FredJ21/Boite_a_M/img/img1.png

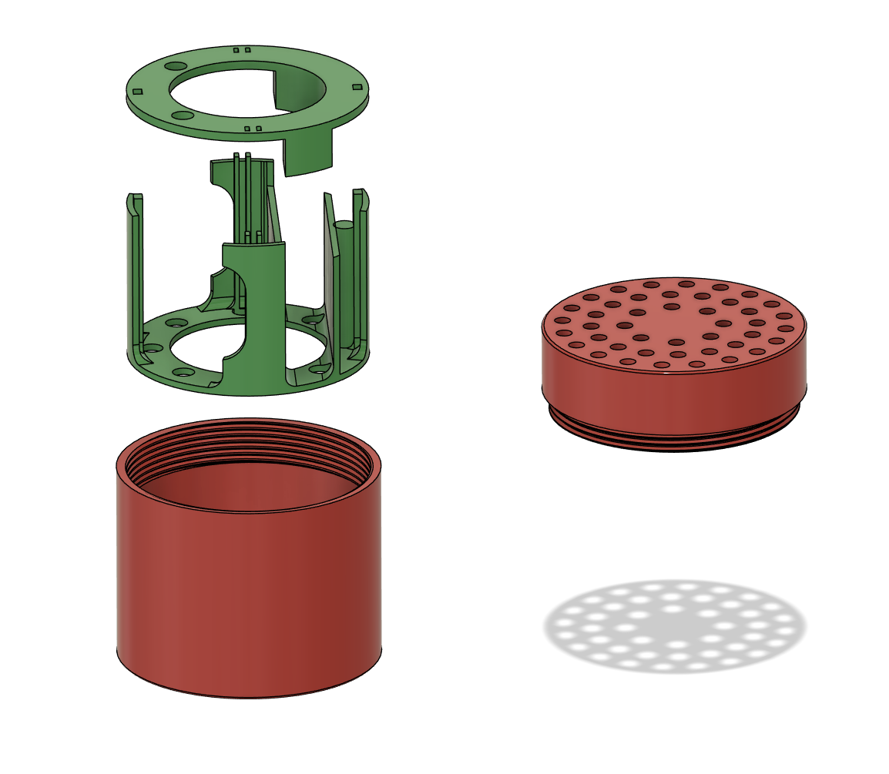
img/img1.png
