FredJ21/Boite_a_M/img/img10.png

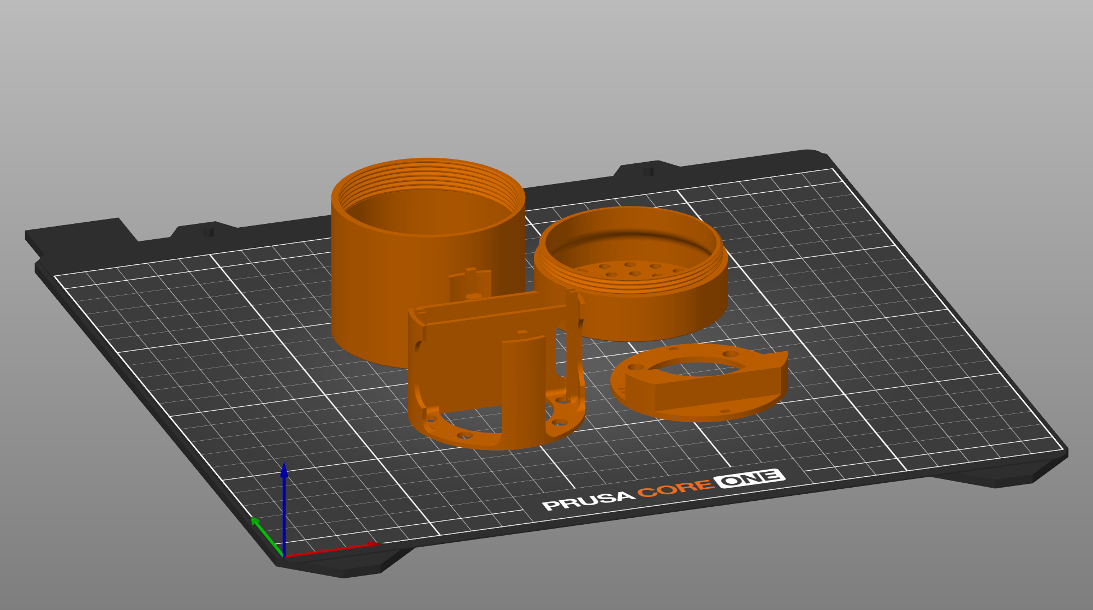
img/img10.png
