FredJ21/Boite_a_M/img/img_4726.png

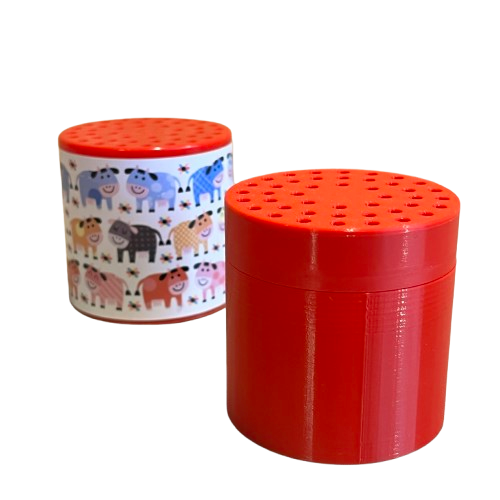
img/img_4726.png
