FredJ21/Boite_a_M/photos/IMG_4679.JPEG

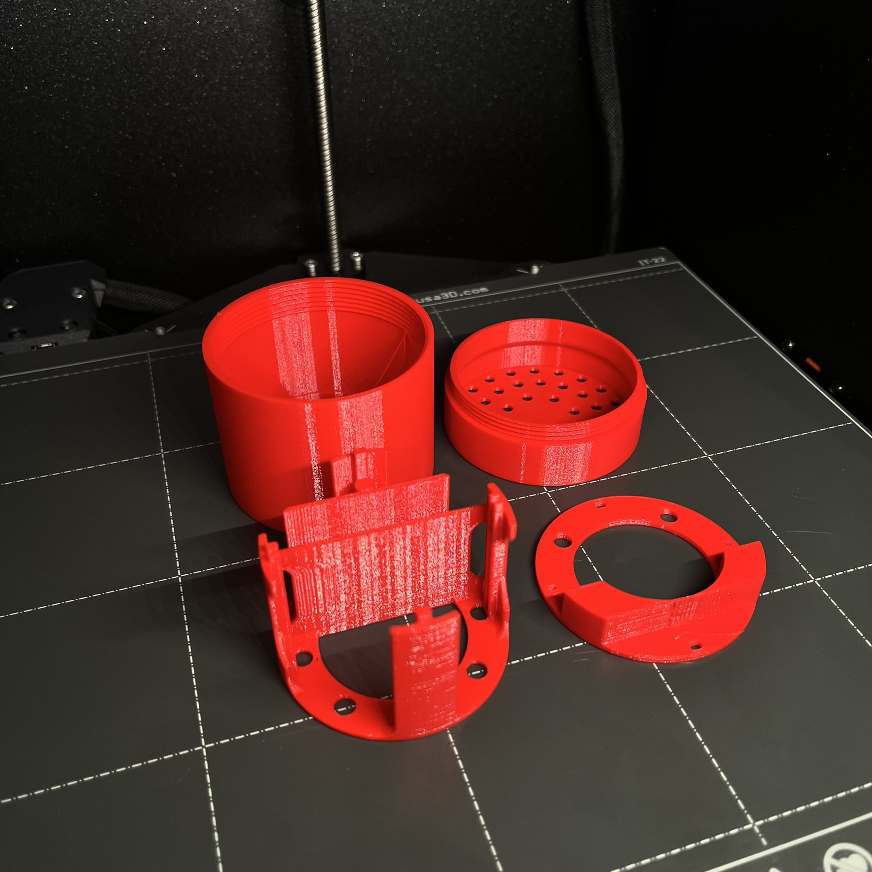
photos/IMG_4679.JPEG
