FredJ21/Boite_a_M/photos/IMG_4681.JPEG

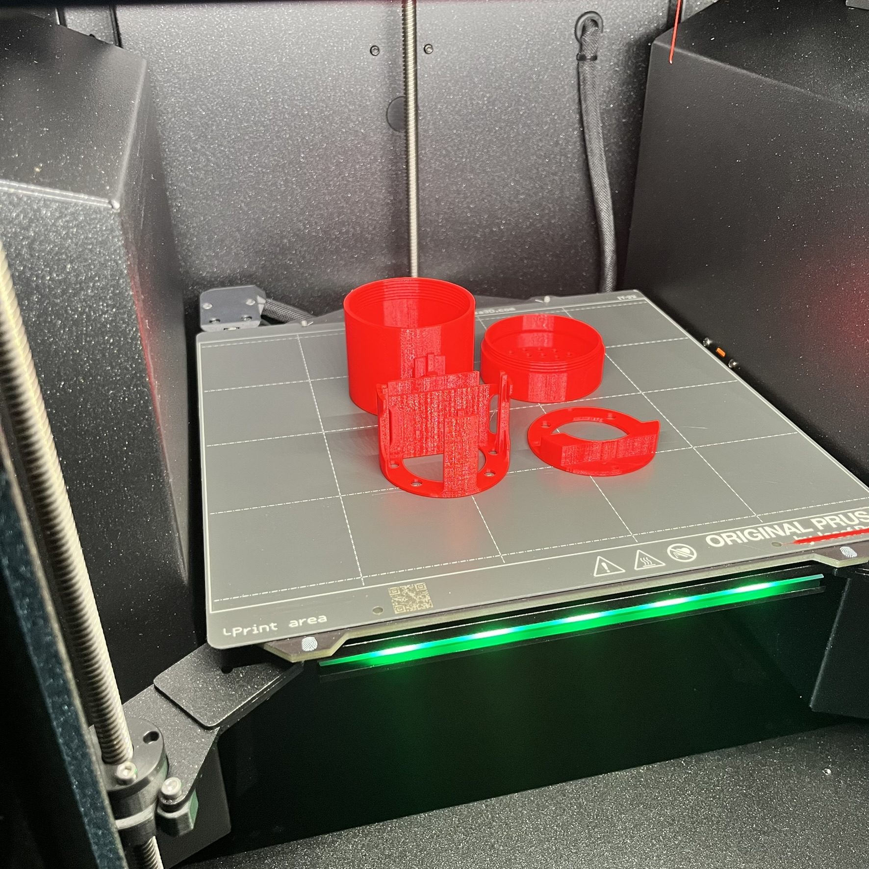
photos/IMG_4681.JPEG
