FredJ21/Boite_a_M/photos/IMG_4686.JPEG

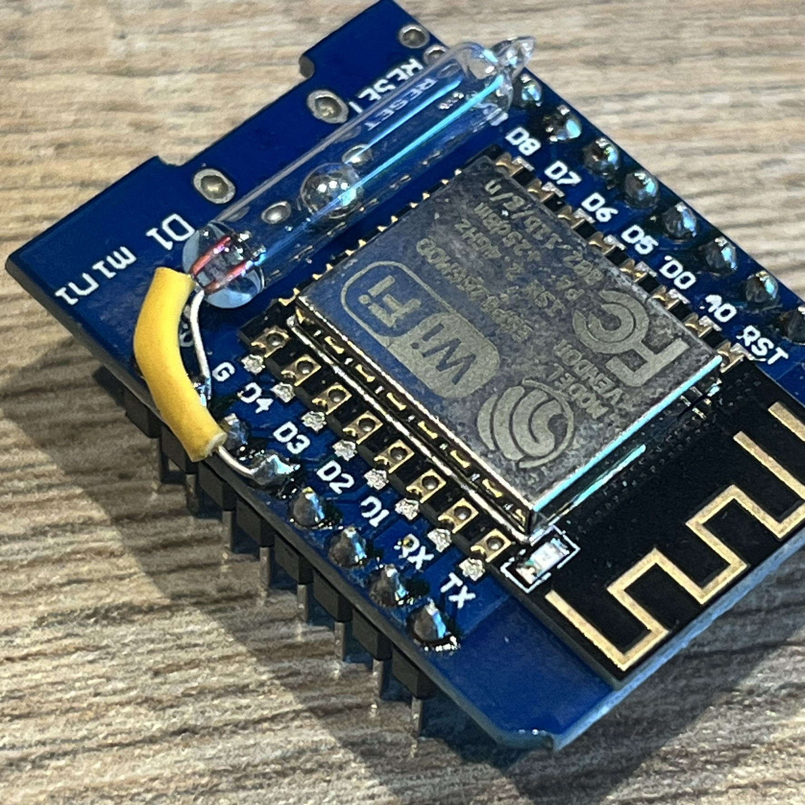
photos/IMG_4686.JPEG
