FredJ21/Boite_a_M/photos/IMG_4687.JPEG

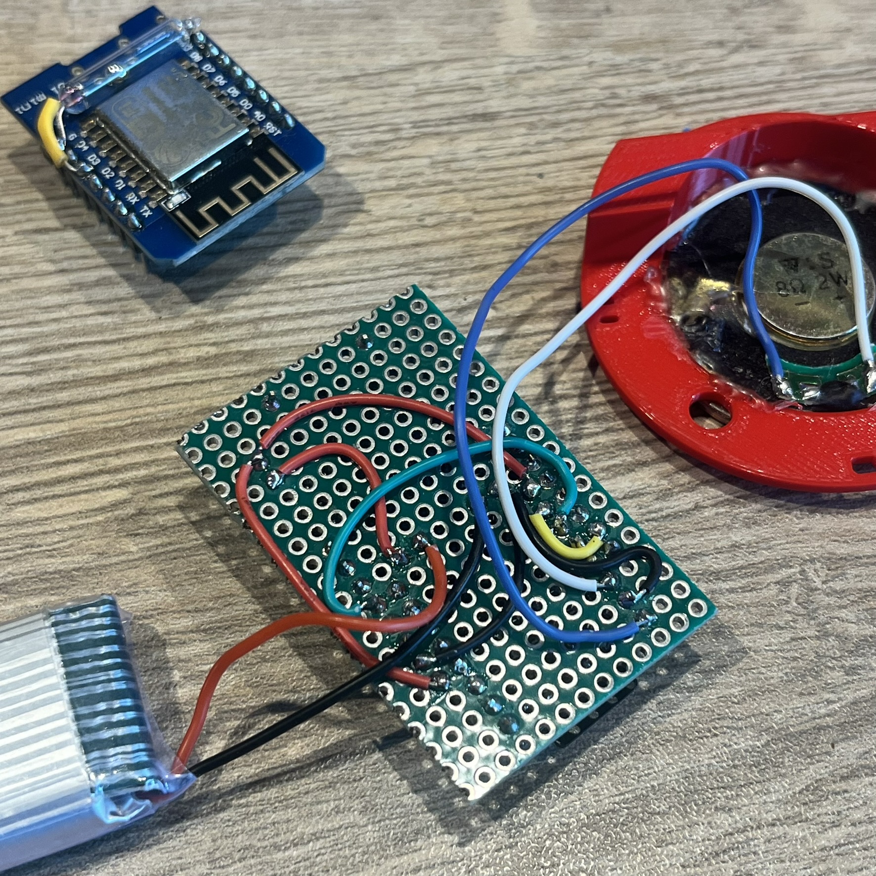
photos/IMG_4687.JPEG
