FredJ21/Boite_a_M/photos/IMG_4689.JPEG

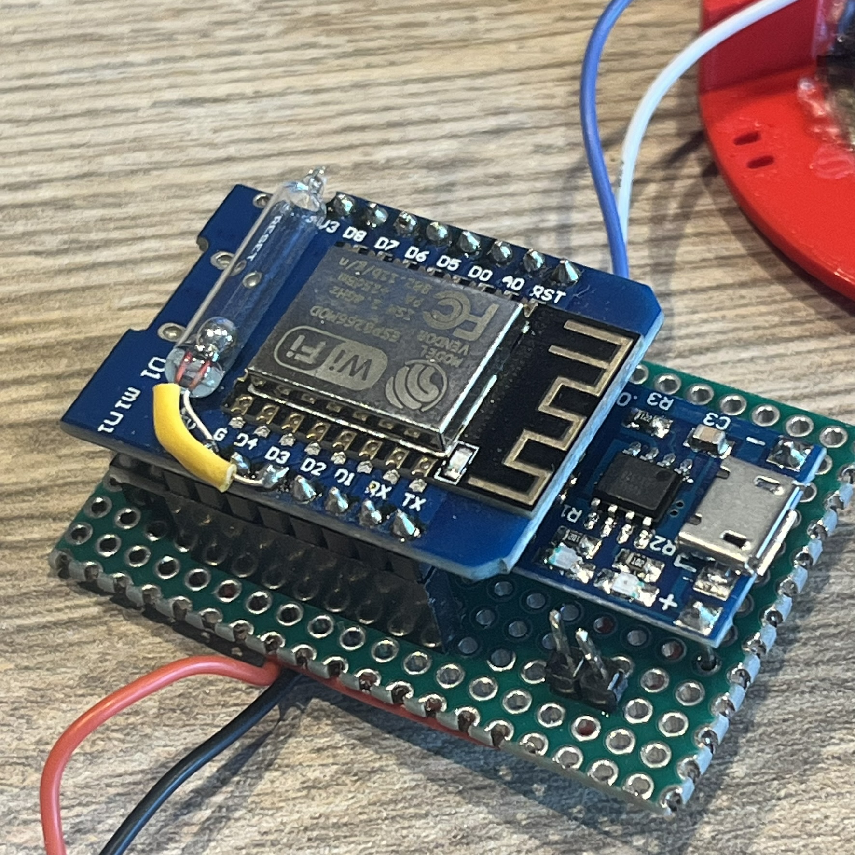
photos/IMG_4689.JPEG
