FredJ21/Boite_a_M/photos/IMG_4724.JPEG

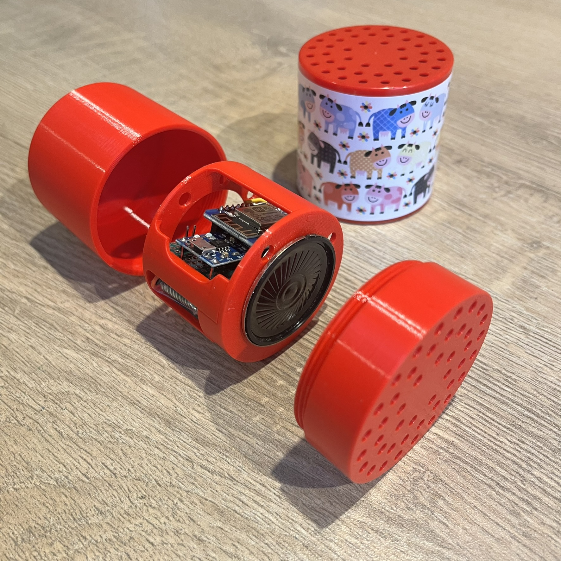
photos/IMG_4724.JPEG
