FredJ21/Boite_a_M/photos/IMG_4725.JPEG

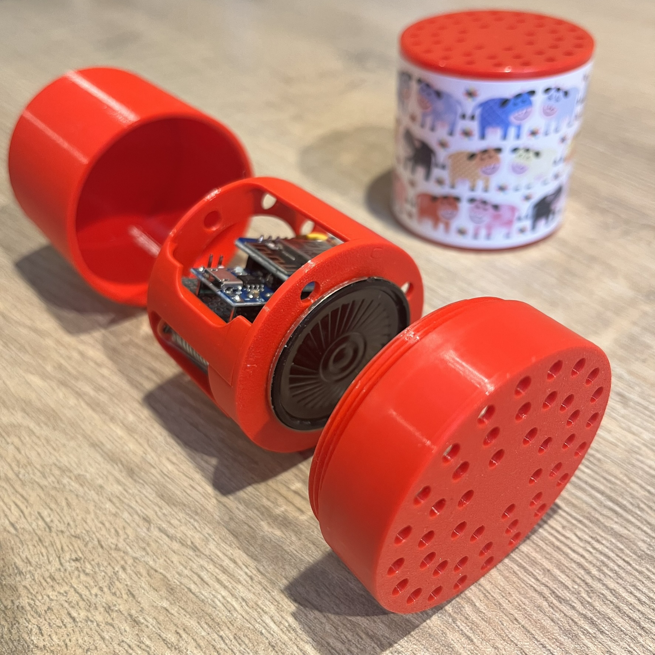
photos/IMG_4725.JPEG
