FredJ21/Boite_a_M/photos/IMG_4727.JPEG

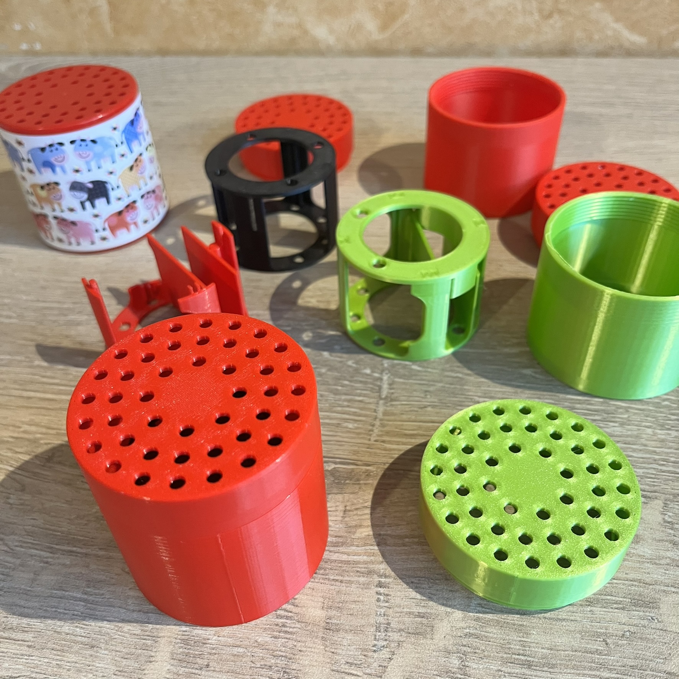
photos/IMG_4727.JPEG
