FredJ21/Boite_a_M/STL/support_ci_2.stl

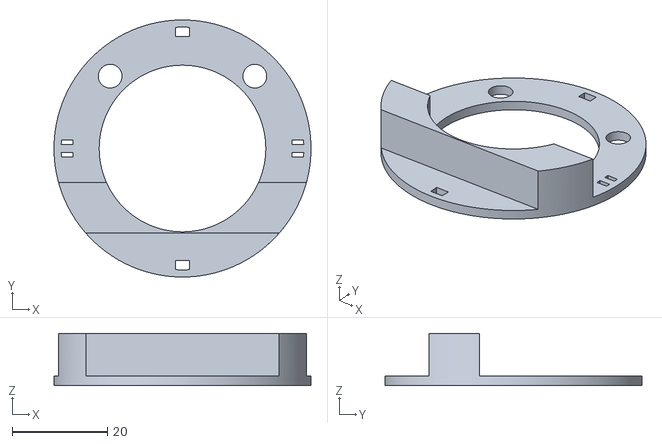
[picture p30: CAD file, 2025-07-22]
STL/support_ci_2.stl
54.0 x 54.0 x 11.0
