FredJ21/Boite_a_M/STL/support_ci_1.stl

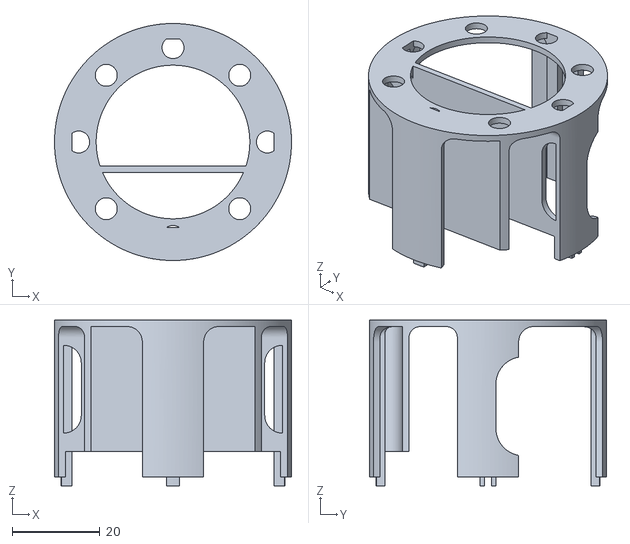
[picture p31: CAD file, 2025-07-22]
STL/support_ci_1.stl
54.0 x 54.0 x 37.8
